pav2000/DevBoardSTM32F103CBT/CubeIDE/Examples/README.md

Постые примеры для платы, среда разработки CubeMX IDE <br>
<br>
1. TimerBlink.zip - мигание светодиодом от таймера <br>
2. USB_VCP.zip - создание виртуального COM порта на USB <br>
3. Пример Mass Storage Class (MSC) в качести хранилища используется spi flash w25q32.
При подключении платы к компу она определяется как флешка объемом 4 MB. Тестировалось на плате 1.5.
Лежит https://github.com/pav2000/USB_W25Q32<br>
4. Подключения китайского лидара (lidar MB-1R2T) к плате (v 1.4) https://github.com/pav2000/LidarStm32f103<br>
<br>
