pav2000/DevBoardSTM32F103CBT/Arduino/tools/README.md

Полезные утилиты/программы.<br>
<br>
ModbusTool.zip - программа эмуляции slave modbus на компе по windows. Предназначена для чтения/записи регистров modbus на master
 устройстве. Позволяет использовать различные функции и читать/писать несколько подряд регистров в цикле.
 В настройках можно выбрать параметры обмена и порядок байт (что важно) в данных. Недостаток - периодически хочет денег.<br>
 Программа является не уникальной и существет множесто аналогов ее под разные операционные системы.<br>
 <br>
 driver_ch340_341_arduino.zip - Виндовс драйвера для чипа ch340 (конвертор usb-uart). Обычно такие конверторы используются для
 соединения с компьютером устройств по rs485 интрефейсу (поверх которого может работать modbus протокол). <br>
<br>
