pav2000/DevBoardSTM32F103CBT/Board/Schematic_v150_2022-01-12.pdf

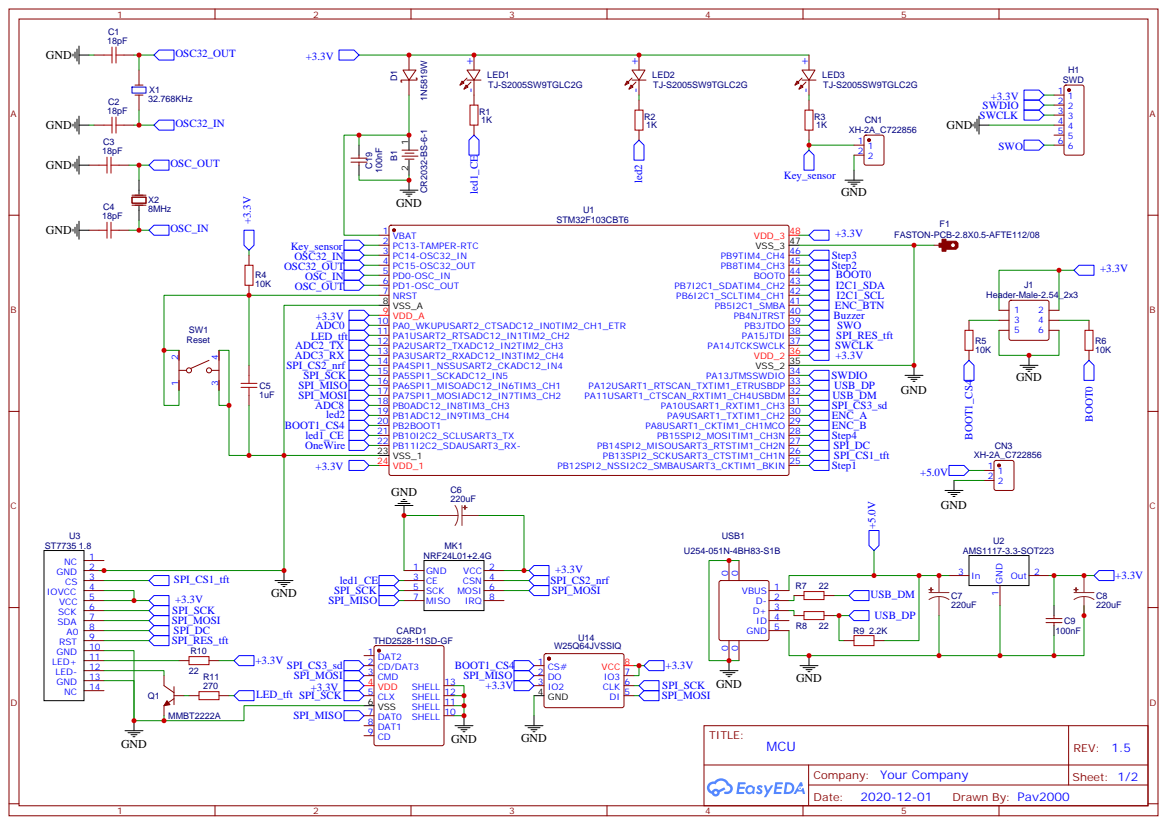
[picture p22: page 1]

SHELL 10 SHELL 11 SHELL 12 SHELL 13

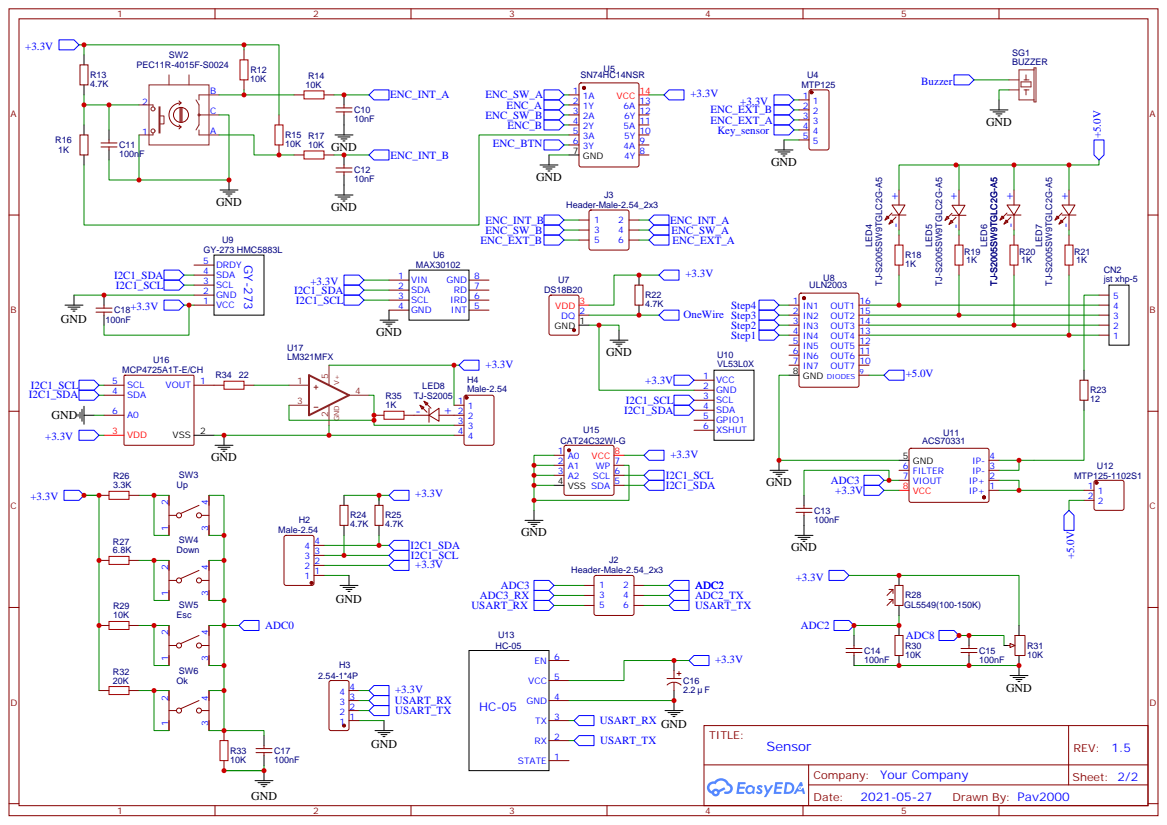
[picture p23: page 2]
