pav2000/DevBoardSTM32F103CBT/Board/Schematic_v140_2021-09-27.pdf

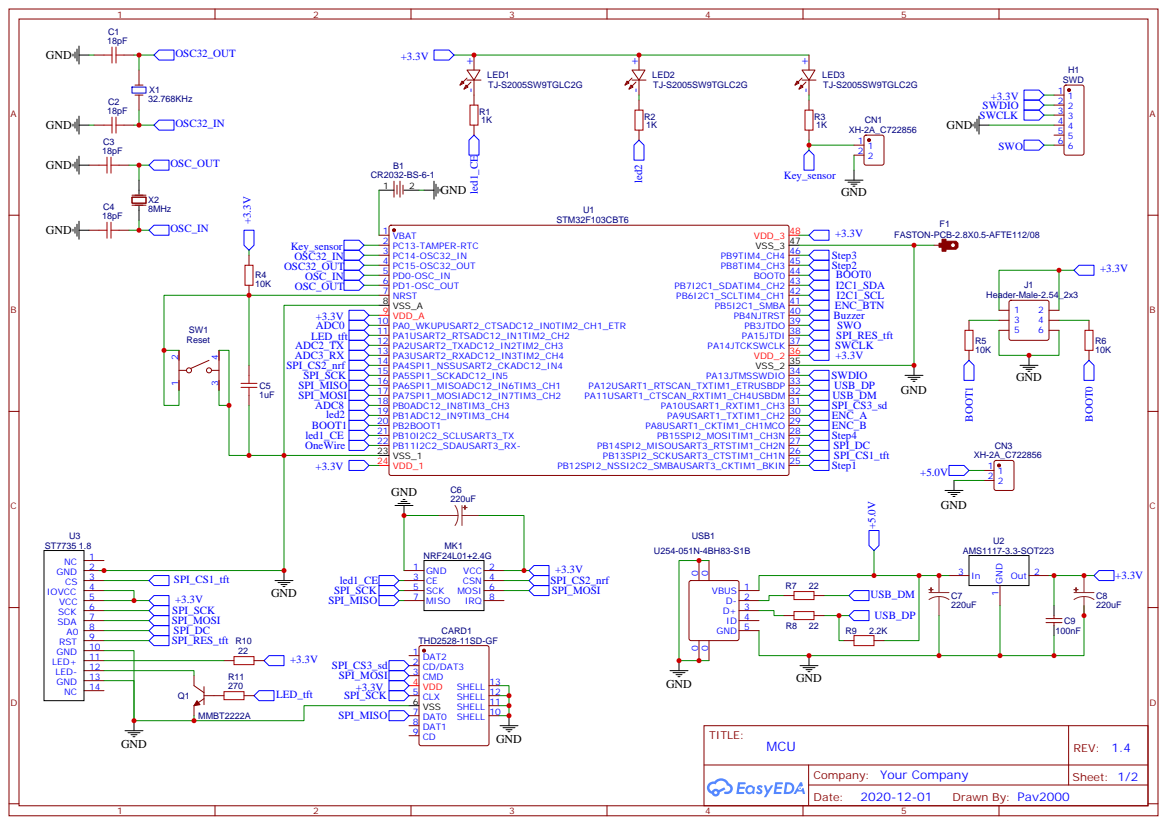
[picture p24: page 1]

SHELL 10 SHELL 11 SHELL 12 SHELL 13

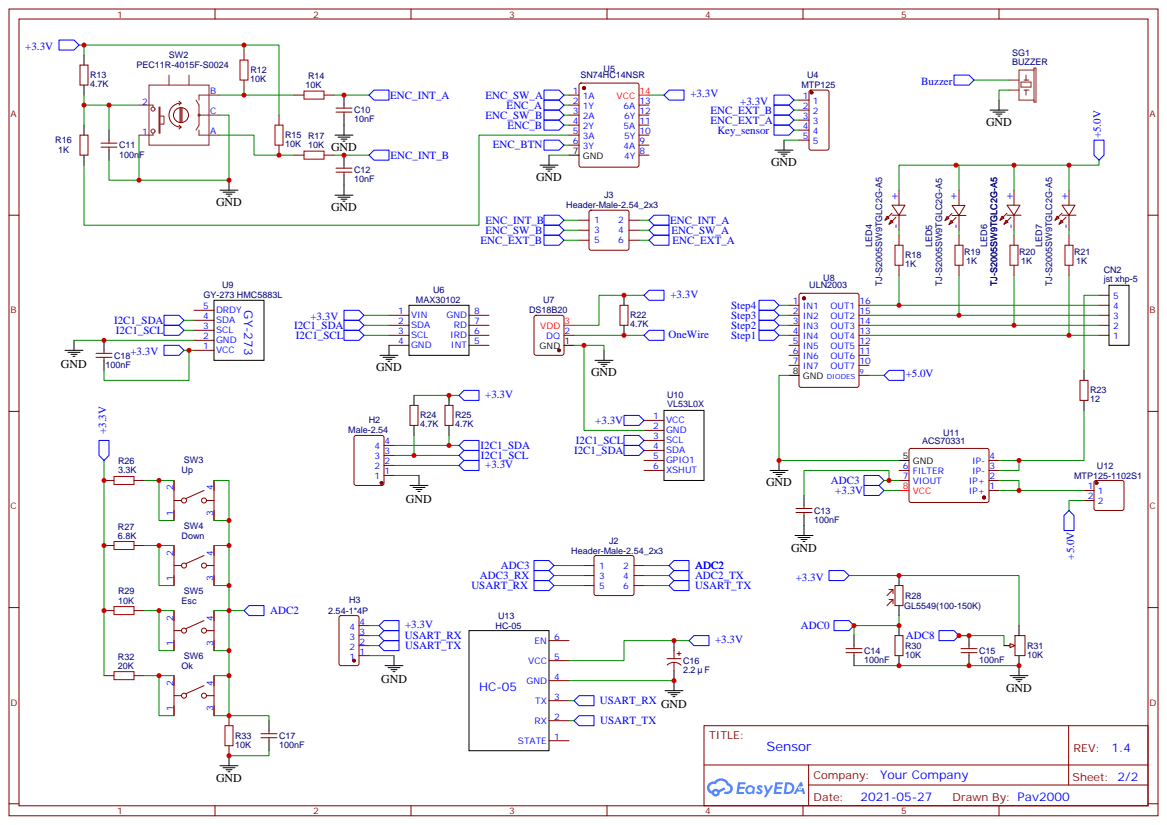
[picture p25: page 2]
