pav2000/DevBoardSTM32F103CBT/Board/Old_version/Schematic_v110_2021-06-04.pdf

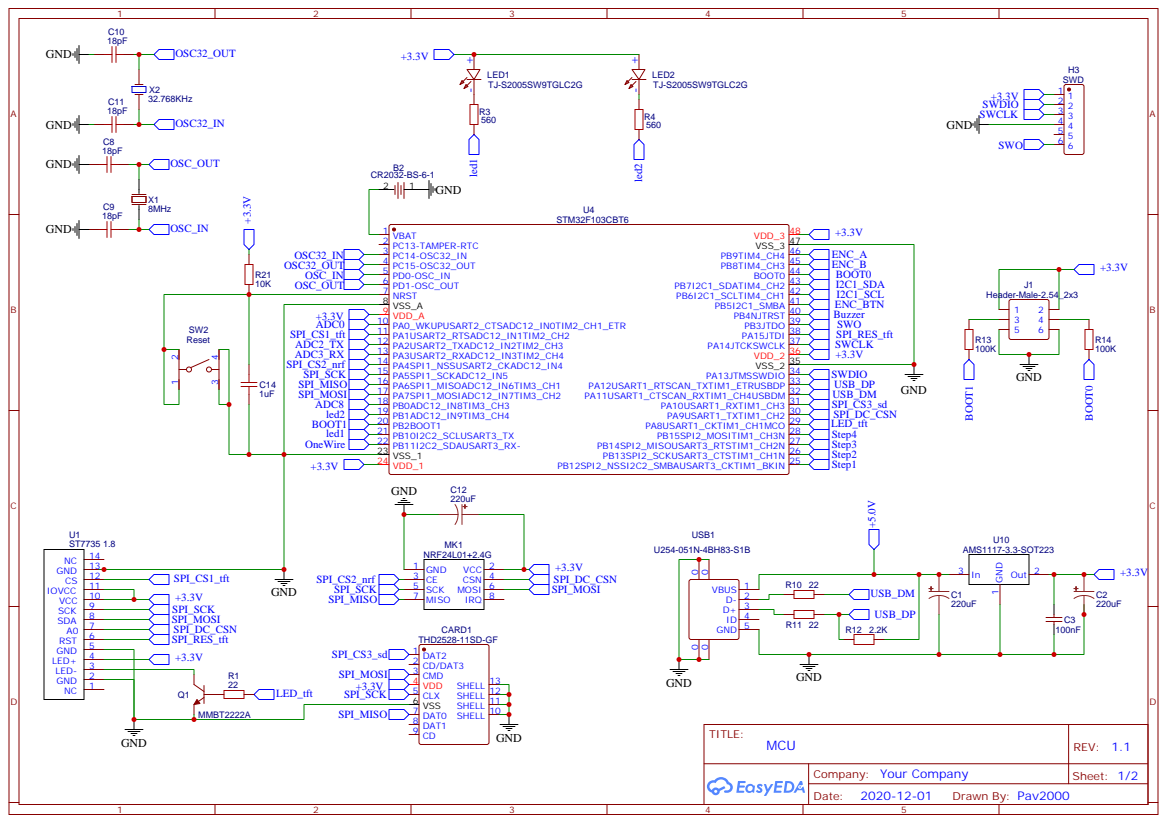
[picture p26: page 1]

SHELL 10 SHELL 11 SHELL 12 SHELL 13

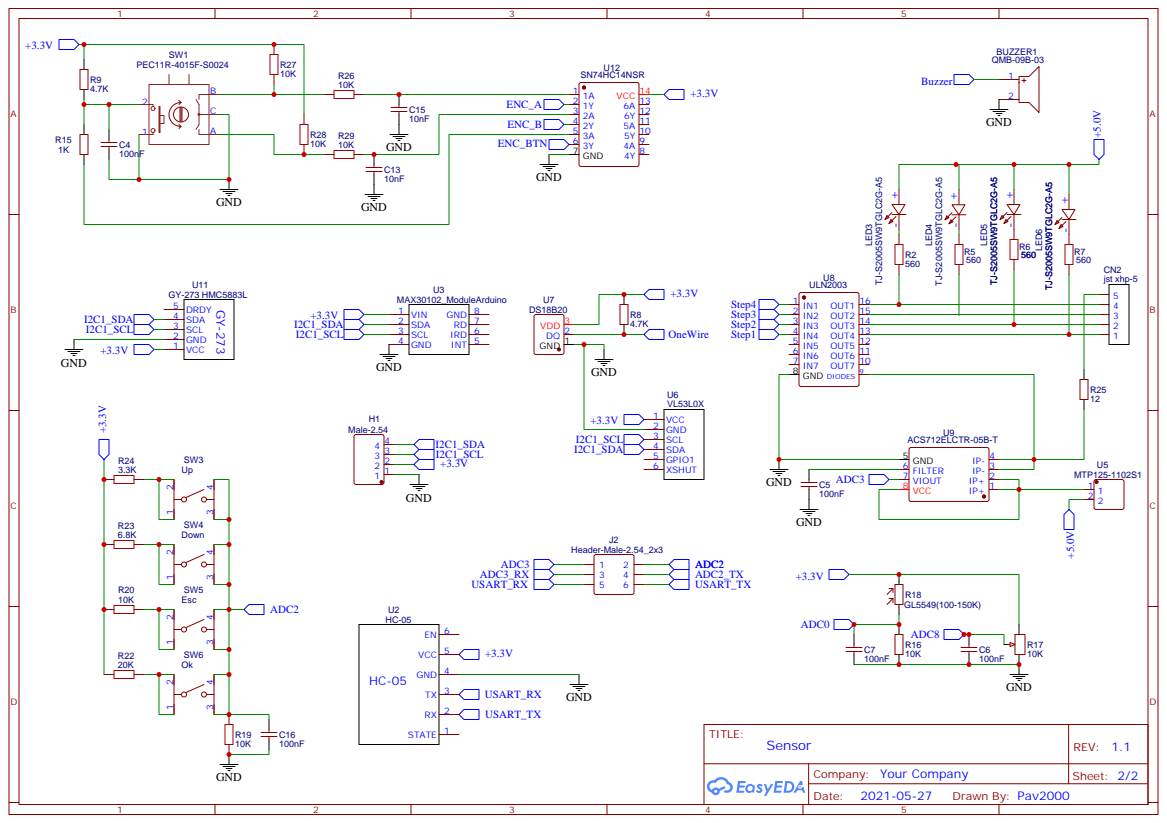
[picture p27: page 2]
