pav2000/DevBoardSTM32F103CBT/Board/Old_version/Schematic_v120_2021-07-21.pdf

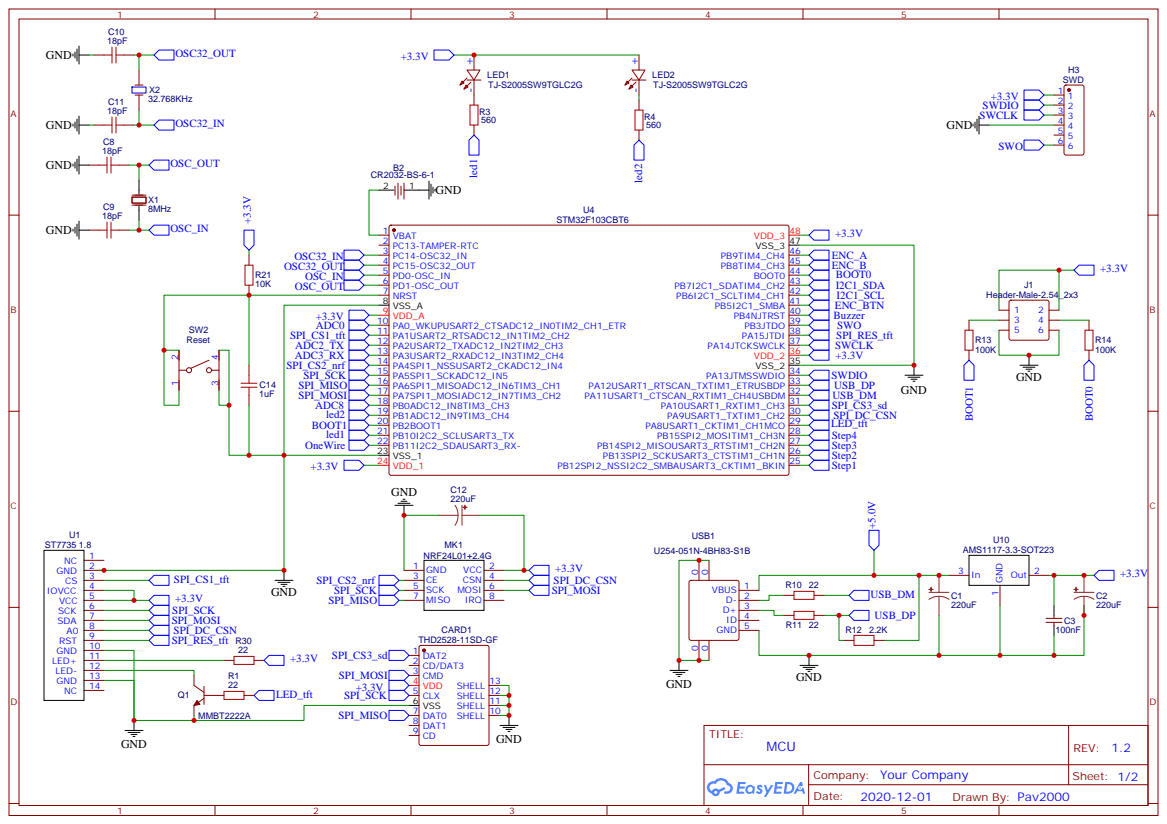
[picture p28: page 1]

SHELL 10 SHELL 11 SHELL 12 SHELL 13

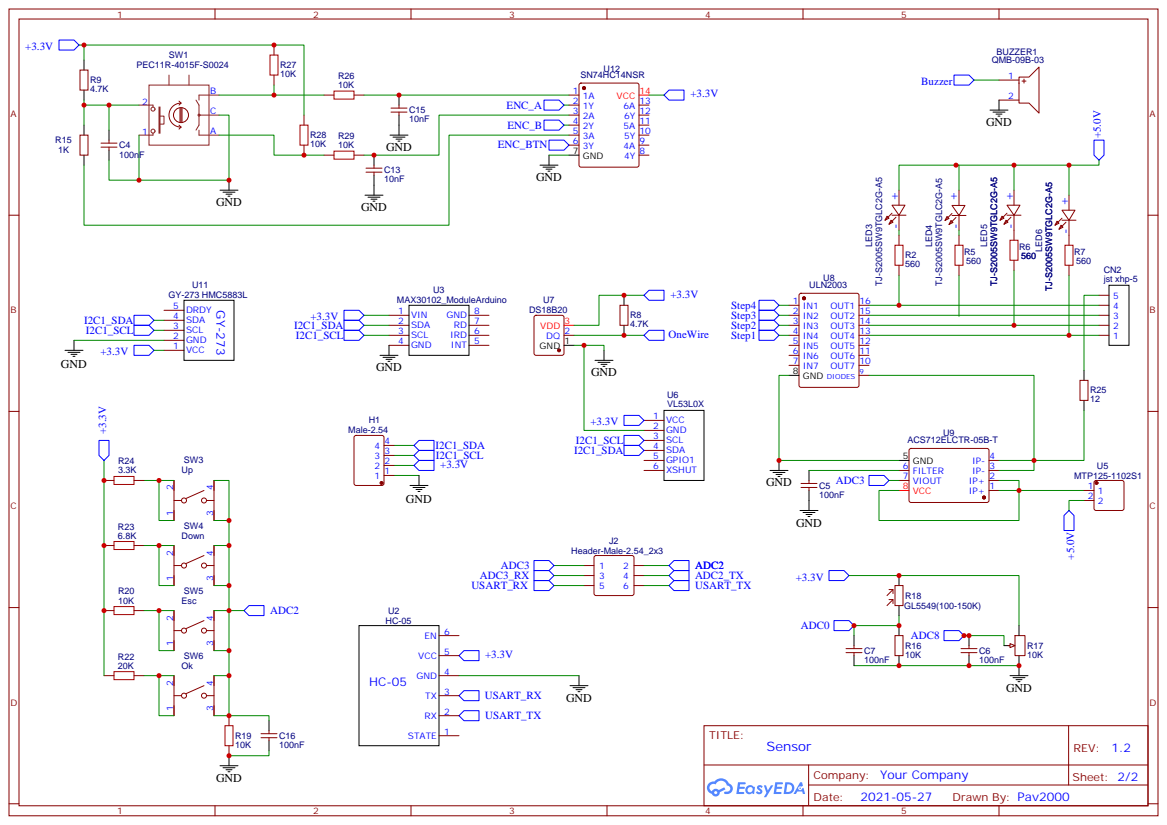
[picture p29: page 2]
