pav2000/DevBoardSTM32F103CBT/Board/Old_version/Schematic_v130_2021-08-02.pdf

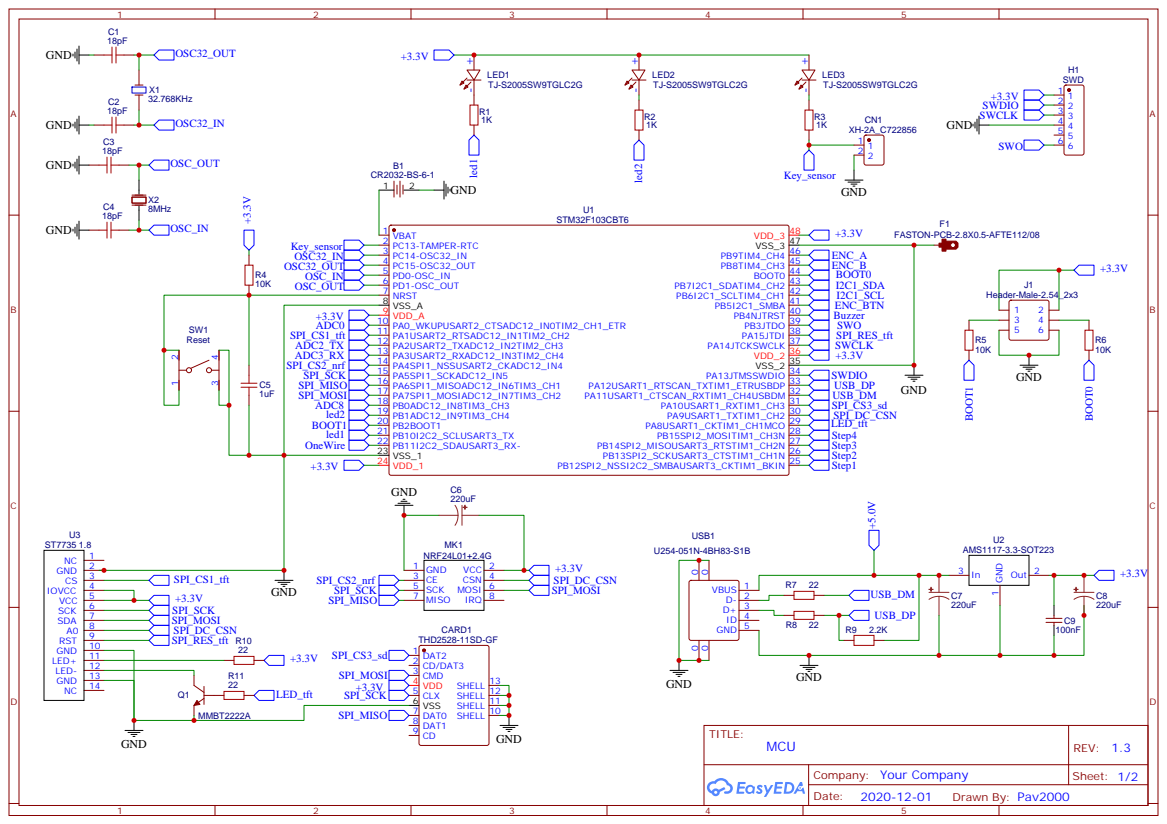
[picture p30: page 1]

SHELL 10 SHELL 11 SHELL 12 SHELL 13

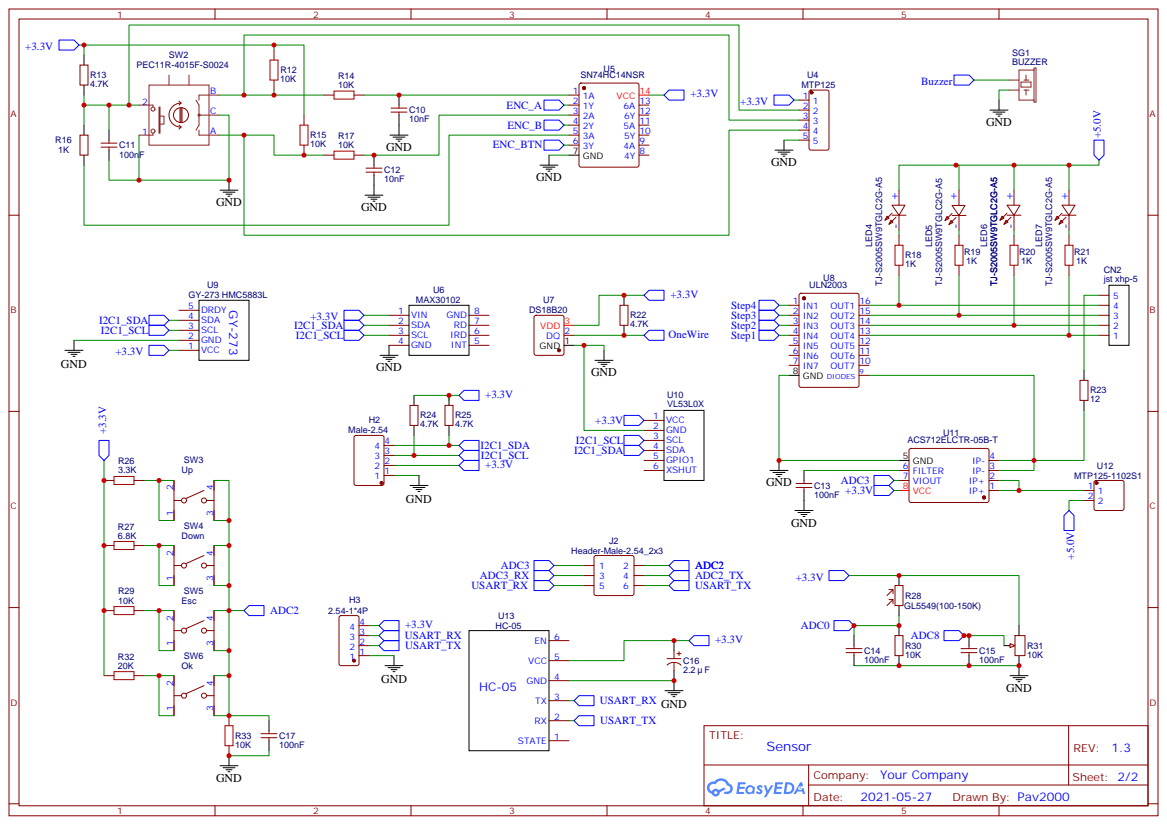
[picture p31: page 2]
