pav2000/DevBoardSTM32F103CBT/CubeIDE/LabMaketTest/Core/Src/main.c

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
/* Includes ------------------------------------------------------------------*/
#include "main.h"
#include "fatfs.h"

/* USER CODE BEGIN Includes */
#include "testimg.h"

/* USER CODE END Includes */

ADC_HandleTypeDef hadc1;

I2C_HandleTypeDef hi2c1;

RTC_HandleTypeDef hrtc;

SPI_HandleTypeDef hspi1;
DMA_HandleTypeDef hdma_spi1_tx;

TIM_HandleTypeDef htim1;
TIM_HandleTypeDef htim2;

/* USER CODE BEGIN PV */
RTC_TimeTypeDef RtcTime;
RTC_DateTypeDef RtcDate;

uint8_t r = 0;
char buf[64];
int EncVal=0;
const char *menu_main_text[NUM_MENU_MAIN]={"0.Test TFT st7735",
										   "1.Test analog sensor",
										   "2.Test key & leds",
										   "3.Test RTC stm32",
										   "4.Test ds18b20",
										   "5.Test I2C bus >>",
										   "6.Test motor&ACS70331",
										   "7.Test SD card",
										   "8.Test nrf24l01",
										   "9.Test SPI flash",
										   "a.Test fake stm chip"};

uint8_t menu_main = 0;
uint8_t menu_i2c = 0;
mMenu myMenu;   // текущее мению
/* USER CODE END PV */

void SystemClock_Config(void);
static void MX_GPIO_Init(void);
static void MX_DMA_Init(void);
static void MX_SPI1_Init(void);
static void MX_ADC1_Init(void);
static void MX_RTC_Init(void);
static void MX_TIM1_Init(void);
static void MX_TIM2_Init(void);
static void MX_I2C1_Init(void);
/* USER CODE BEGIN PFP */
extern void start_screen(void);
extern void beep(uint16_t t);
extern void beep_enc(void);
extern void menu_i2c_screen(void);
extern void test_TFT(void);
extern void test_ADC(void);
extern void test_keyADC_LEDS(void);
extern void test_RTC(void);
extern void test_ds18b20(void);
extern void scan_i2c(void);
extern void test_VL53L0x(void);
extern void test_max30102(void);
extern void test_hmc5883l(void);
extern void test_SD(void);
extern void test_nrf24(void);
extern void test_SPI_flash(void);
void test_Stepper(void);
/* USER CODE END PFP */

/* USER CODE BEGIN 0 */
uint32_t CalculateDayNumber(uint8_t Date, uint8_t Month, uint8_t Year)
{
	// Format:
	// DD.MM.YY
	uint32_t _Year = Year + 20;
	Month = (Month + 9) % 12;
	_Year = _Year - (Month / 10);
	return ((365 * _Year) + (_Year / 4) - (_Year / 100) + (_Year / 400) + (((Month * 306) + 5) / 10) + (Date - 1));
}

void CalculateDateFromDayNumber(uint32_t DayNumber, uint8_t *Date, uint8_t *Month, uint8_t *Year)
{
	uint32_t _Date, _Month, _Year;
	_Year = ((10000 * DayNumber) + 14780) / 3652425;
	int32_t ddd = DayNumber - ((365 * _Year) + (_Year / 4) - (_Year / 100) + (_Year / 400));
	if (ddd < 0)
	{
		_Year -= 1;
		ddd = DayNumber - ((365 * _Year) + (_Year / 4) - (_Year / 100) + (_Year / 400));
	}
	int32_t mi = ((100 * ddd) + 52) / 3060;
	_Month = (mi + 2) % 12 + 1;
	_Year = _Year + (mi + 2)/12;
	_Date = ddd - ((mi * 306) + 5)/10 + 1;
	*Date = _Date;
	*Month = _Month;
	*Year = _Year - 20;
}
/* USER CODE END 0 */

/**
  * @brief  The application entry point.
  * @retval int
  */
int main(void)
{
  /* USER CODE BEGIN 1 */
uint8_t old_menu = menu_main;  // Старая позиция меню
  /* USER CODE END 1 */

  /* MCU Configuration--------------------------------------------------------*/

  /* Reset of all peripherals, Initializes the Flash interface and the Systick. */
  HAL_Init();

  /* Configure the system clock */
  SystemClock_Config();

  /* Initialize all configured peripherals */
  MX_GPIO_Init();
  MX_DMA_Init();
  MX_SPI1_Init();
  MX_ADC1_Init();
  MX_RTC_Init();
  MX_FATFS_Init();
  MX_TIM1_Init();
  MX_TIM2_Init();
  MX_I2C1_Init();
  /* USER CODE BEGIN 2 */

  ST7735_Init();          // Не забываем в кубе настроить DMA
 // ST7735_Backlight_On(); // Включить подсветку дисплея
  ST7735_SetRotation(3);
  ST7735_FillScreen(ST7735_WHITE);
  ST7735_DrawImage(0, 10, 160, 58, (const uint16_t*) stm32logo); // вывести заставку
  ST7735_DrawString(0, 108, "Hardware version:", Font_7x10, ST7735_RED, ST7735_WHITE);
  ST7735_DrawString(130, 108, HARDWARE, Font_7x10, ST7735_RED, ST7735_WHITE);

  ST7735_DrawString(0, 118, "Test prog version:", Font_7x10, ST7735_RED, ST7735_WHITE);
  ST7735_DrawString(130, 118, VERSION, Font_7x10, ST7735_RED, ST7735_WHITE);
  beep(200);
  HAL_TIM_PWM_Start(&htim2, TIM_CHANNEL_2); // Включить ШИМ на подсветку дисплея
  for (uint8_t i=0;i<100;i++){
	  ST7735_Backlight(i);                  // Установить ярокость
	  HAL_Delay(20);
  }
// test_VL53L0x();
// test_at24c128();
  HAL_ADCEx_Calibration_Start(&hadc1);  // Калибровка ацп
  /* USER CODE END 2 */

  /* Infinite loop */
  /* USER CODE BEGIN WHILE */
 // HAL_GPIO_WritePin(GPIOB, LED2_Pin, GPIO_PIN_SET);    // Установить светодиод 2 в 1
  HAL_GPIO_WritePin(LED1_CE_NRF_GPIO_Port, LED1_CE_NRF_Pin, GPIO_PIN_RESET);    // Установить светодиод 1 в 0
 // HAL_GPIO_WritePin(GPIOA, TFT_LED_Pin, GPIO_PIN_SET); // Включить подсветку дисплея


  start_screen();
  TIM1->ARR = (NUM_MENU_MAIN-1)*2+1; // Установить максимальное значение энкодера в ДВА раза больше чем пунктов меню (срабатываение на один щелчек энкодера)
  TIM1->CNT = 0; // нулевой пункт меню
  HAL_TIM_Encoder_Start(&htim1, TIM_CHANNEL_ALL); // Включить энкодер

  HAL_NVIC_EnableIRQ(EXTI9_5_IRQn);
 // myMenu=mMain;    // текущее меню - главное
  while (1)
  {
	  HAL_GPIO_TogglePin(LED1_CE_NRF_GPIO_Port, LED1_CE_NRF_Pin); // Инвертирование состояния выхода.
	  HAL_Delay(50);                       // Пауза 50 миллисекунд.

	 menu_main = __HAL_TIM_GET_COUNTER(&htim1)/2;  // Прочитать значение энкодера

     if(old_menu!=menu_main) // Надо перерисовать пункт меню
     {
 //	  itoa(menu_main+1,buf,16);
 //	  ST7735_DrawString(150, 1, buf, Font_7x10, ST7735_RED, ST7735_BLUE); // текущий атом меню
    	// Старое меню восстанавливаем
   	  ST7735_FillRectangle(0, 2+(old_menu+1)*STR_H, 160-1,STR_H, ST7735_BLACK);
      ST7735_DrawString(0, 2+(old_menu+1)*STR_H,menu_main_text[old_menu], Font_7x10, ST7735_WHITE, ST7735_BLACK);
    	// Новое рисуем
   	  ST7735_FillRectangle(0, 2+(menu_main+1)*STR_H, 160-1,STR_H, ST7735_WHITE);
      ST7735_DrawString(0, 2+(menu_main+1)*STR_H,menu_main_text[menu_main], Font_7x10, ST7735_BLUE, ST7735_WHITE);
      old_menu=menu_main;
      beep_enc();
     }
     // Нажата кнопка
     if (HAL_GPIO_ReadPin(GPIOB, ENC_BTN_Pin) == 1) {
    	 beep_enc();
    	 switch (menu_main){
    		case 0: test_TFT();start_screen(); break;
    		case 1: test_ADC();start_screen(); break;
    		case 2: test_keyADC_LEDS();start_screen(); break;
      		case 3: test_RTC();start_screen(); break;
      		case 4: test_ds18b20();start_screen(); break;
      		case 5: menu_i2c_screen();TIM1->CNT=5*2; start_screen(); break; // Подменю, с возвратом на ту же позицию
      		case 6: test_Stepper();start_screen(); break;
    		case 7: test_SD();start_screen(); break;
    		case 8: test_nrf24();start_screen(); break;
    		case 9: test_SPI_flash();start_screen(); break;
    		case 10: test_fake_stm32();start_screen(); break;
      		default: break;

    	}
     }

    /* USER CODE END WHILE */

    /* USER CODE BEGIN 3 */
  }
  /* USER CODE END 3 */
}

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
/* USER CODE BEGIN 4 */
/*
// Прерывание от энкодера
static uint32_t tick_encoder=0;
#define ENC_BOUNCE   10  // Дребезг энкодера
void HAL_GPIO_EXTI_Callback(uint16_t GPIO_Pin)
{

  if(GPIO_Pin == ENC_B_Pin) {  // Нужное прерываение от нужной ножки
      HAL_GPIO_TogglePin(GPIOB, LED2_Pin); // Инвертирование состояния выхода.
      if((HAL_GetTick()-tick_encoder>ENC_BOUNCE)&&(HAL_GPIO_ReadPin(GPIOB, ENC_B_Pin) == 0)) {// С прошедшего прерываения прошло более 20 мс - это не дребезг
      tick_encoder=HAL_GetTick();
        switch (myMenu){
   		case mMain:// {
   		    if ((HAL_GPIO_ReadPin(GPIOB, ENC_A_Pin) == 1)&&(HAL_GPIO_ReadPin(GPIOB, ENC_A_Pin) == 1)) { // Кто-то крутит ручку по часовой стрелке
   		    	HAL_Delay(1);   if (HAL_GPIO_ReadPin(GPIOB, ENC_A_Pin) == 1)
   		              if(menu_main <  NUM_MENU_MAIN-1) menu_main++; }
   		      else if ((HAL_GPIO_ReadPin(GPIOB, ENC_A_Pin) == 0)&&(HAL_GPIO_ReadPin(GPIOB, ENC_A_Pin) == 0)) { // Ручку крутят против часовой стрелки
   		    	HAL_Delay(1);   if (HAL_GPIO_ReadPin(GPIOB, ENC_A_Pin) == 0)
   		                  if(menu_main > 0) menu_main--; }

   			break;

   		case mI2C: // {
   		    if ((HAL_GPIO_ReadPin(GPIOB, ENC_A_Pin) == 1)&&(HAL_GPIO_ReadPin(GPIOB, ENC_A_Pin) == 1)) { // Кто-то крутит ручку по часовой стрелке
 		    	HAL_Delay(1);   if (HAL_GPIO_ReadPin(GPIOB, ENC_A_Pin) == 1)
     		    	if(menu_i2c <  NUM_MENU_I2C-1) menu_i2c++; }
   		      else if ((HAL_GPIO_ReadPin(GPIOB, ENC_A_Pin) == 0)&&(HAL_GPIO_ReadPin(GPIOB, ENC_A_Pin) == 0)) { // Ручку крутят против часовой стрелки
   		    	HAL_Delay(1);   if (HAL_GPIO_ReadPin(GPIOB, ENC_A_Pin) == 1)
       	    	  if(menu_i2c > 0) menu_i2c--; }
     		break;

      }

  } else{
   __NOP();
  } }
  __HAL_PWR_CLEAR_FLAG(PWR_FLAG_WU);
}
*/
/* USER CODE END 4 */
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
