pav2000/DevBoardSTM32F103CBT/CubeIDE/LabMaketTest/Core/Inc/main.h

#define HARDWARE "1.50"     // Версия платы (обязательно указывать)
#define VERSION  "1.58"     // Версия тестовой программы
#define STR_H           10  // Высота строки
#define NUM_MENU_MAIN   11  // Число пунктов основного меню
#define NUM_MENU_I2C    7   // Число пунктов i2c меню
#define LED3_Pin GPIO_PIN_13
#define LED3_GPIO_Port GPIOC
#define SPI_CS2_nrf_Pin GPIO_PIN_4
#define SPI_CS2_nrf_GPIO_Port GPIOA
#define LED2_Pin GPIO_PIN_1
#define LED2_GPIO_Port GPIOB
#define BOOT1_CS4_Pin GPIO_PIN_2
#define BOOT1_CS4_GPIO_Port GPIOB
#define LED1_CE_NRF_Pin GPIO_PIN_10
#define LED1_CE_NRF_GPIO_Port GPIOB
#define ONEWIRE_Pin GPIO_PIN_11
#define ONEWIRE_GPIO_Port GPIOB
#define STEP1_Pin GPIO_PIN_12
#define STEP1_GPIO_Port GPIOB
#define TFT_CS_Pin GPIO_PIN_13
#define TFT_CS_GPIO_Port GPIOB
#define TFT_DC_Pin GPIO_PIN_14
#define TFT_DC_GPIO_Port GPIOB
#define STEP4_Pin GPIO_PIN_15
#define STEP4_GPIO_Port GPIOB
#define ENC_B_Pin GPIO_PIN_8
#define ENC_B_GPIO_Port GPIOA
#define ENC_A_Pin GPIO_PIN_9
#define ENC_A_GPIO_Port GPIOA
#define SD_CS_Pin GPIO_PIN_10
#define SD_CS_GPIO_Port GPIOA
#define TFT_RST_Pin GPIO_PIN_15
#define TFT_RST_GPIO_Port GPIOA
#define INT_MAX30102_Pin GPIO_PIN_3
#define INT_MAX30102_GPIO_Port GPIOB
#define BUZZER_Pin GPIO_PIN_4
#define BUZZER_GPIO_Port GPIOB
#define ENC_BTN_Pin GPIO_PIN_5
#define ENC_BTN_GPIO_Port GPIOB
#define STEP2_Pin GPIO_PIN_8
#define STEP2_GPIO_Port GPIOB
#define STEP3_Pin GPIO_PIN_9
#define STEP3_GPIO_Port GPIOB
