pav2000/DevBoardSTM32F103CBT/CubeIDE/LabMaketTest/Core/Inc/testimg.h

/*
 * testimg.h
 *
 *  Created on: Sep 15, 2020
 *      Author: Admin
 */

#ifndef INC_TESTIMG_H_
#define INC_TESTIMG_H_
const uint16_t test_img_128x128[][128] = {
{0x0B6B,0x0B63,0x0B6B,0x2B6B,0x2B6B,0x2B6B,0x2C6B,0x2C6B,0x2B6B,0x2C6B,0xAC73,0xAB84,0xCB9D,0xECB6,0xCCCF,0xECE7,0xECEF,0xEBF7,0xEAFF,0xEBFF,0xEBFF,0xEBFF,0xEDF7,0xEDE7,0xCCDF,0xAADF,0x4FCF,0xDDB6,0xDFB6,0xDFBE,0x1E96,0xFC74,0xFC53,0xDD5B,0xBE7C,0x5F95,0xBFA5,0xFFAD,0x1F8D,0xFC63,0x7753,0xD44A,0xD552,0x355B,0xF352,0x7142,0xB652,0x3B5B,0x3D7C,0x7D6C,0x5E8D,0x7EBE,0xDFCE,0x9B95,0x5A74,0x5A8C,0xBC94,0xBB8C,0xB88C,0xB78C,0x5484,0x137C,0x347C,0x5384,0x7473,0x9B73,0xDFAD,0xDFBE,0x1FA6,0xB974,0x303A,0x5129,0xB639,0x1E7C,0x3FB6,0xFFBE,0x3D7D,0x3D64,0x1E6C,0xBD5B,0x5C4B,0x7C53,0x3C4B,0xFD42,0x3D53,0x7FA5,0x9FB6,0x3F8D,0x7F74,0x9F74,0x5E74,0xDF84,0x5FB6,0x5A8D,0x795B,0xBE63,0x9F7C,0x3FB6,0xDFCE,0x7FB6,0x7E95,0xBFCE,0xFDB6,0xCE63,0xA95A,0xC95A,0x895A,0x8A5A,0x695A,0x6952,0x6952,0x4952,0x484A,0x484A,0x084A,0x084A,0x0742,0xE741,0xC741,0xC739,0xC639,0xA639,0x8631,0x8531,0x6531,0x6531,0x4429,0x2429,},
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
		0XFF,0XFF,0XFF,0XFF,0XFF,0XFF,0XFF,0XFF,0XFF,0XFF,0XFF,0XFF,0XFF,0XFF,0XFF,0XFF,
		0XFF,0XFF,0XE7,0XFF,0X45,0X7B,0X0C,0XDB,0X04,0XFB,0X04,0XFC,0X04,0XFC,0X0C,0XDA,
		0X2C,0XB7,0XC7,0XFF,0XF7,0XFF,0XFF,0XFF,0XFF,0XFF,0XF7,0XFF,0XC7,0XFF,0X34,0XD8,
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
