pav2000/DevBoardSTM32F103CBT/(commit log)

2021-10-25 Первоначальная загрузка
    [LabMaketTest Debug.cfg]
2021-11-10 Подготовка к переходу на плату версии 1.4
2021-11-10 up timer encoder
    [LabMaketTest Debug.cfg]
2021-11-11 Переход на железо 1.4 экран заработал, использование таймера для работы с энкодером version 1.31
2021-11-11 PWM control backlight TFT ver. 1.32
2021-11-11 up 1.34 полная реализация по железу 1.4
2021-11-12 ver 1.35, обновление readme, добавлены схемы предыдущих версий плат.
2021-12-09 Добавлено описание различий версий платы и оисания отдельных микросхем
2022-01-10 Add arduino Modbus RTU example & lib
2022-01-10 Обновление ветки для Arduino
2022-01-10 Добавлено описание графической библиотеки Adafruit_GFX
2022-01-12 Начало перехода на железо версии 1.5.
    Добавление коментариев для новой версии платы.
2022-01-12 Версия 1.36
    Добавлено для платы версии 1.50 тестирование SPI флаш памяти. На плате
    установлено w25q32, При тесте происходит чтение служемной информации о
    чипе.
2022-01-12 Версия 1.37
    Алаптация аналоговых входов по железо версии 1.50. Было поменяно местами
    два аналоговых входа adc0 и adc2.
2022-01-12 Версия 1.38
2022-01-13 версия 1.39
    Добавлен простейший тест скороси чтения/записи spi flash памяти
2022-01-17 Версия 1.40
    Добавлен тест чипа at24c128 с использованием HAL
2022-01-17 Версия 1.41
    Добавлен тест dac mcp4725 (i2c)
2022-01-18 update
    Добавленлена программа обмена по modbus и драйвера для чипа ch340
2022-01-20 Update
    Добавление примера для cubeide
2022-01-20 Пример USB_W25Q32 перенесен в отдельный репозитарий.
2022-06-21 ver 1.44 1.Добавлен тест на определение оригинальности stm32f103 (определение подделок) 2. Временно часы тактируются от внутреннего генератора 4-кГц.
    [LabMaketTest Debug.cfg]
2023-01-10 Добавление даташита на датчик AS5600
2023-01-10 lib as5600
    Добавлены библиотеки для работы с датчиком в среде arduino, добавлен список ссылок.
2023-01-10 Add step motor
    Добавлена документация и либы на управление шаговым двигателем
2023-01-11 update redme
    Перевел описание платы на английский язык
2023-01-24 Add samples as5600
    Добавлен протестированный пример на макете (stm32f103) работы с датчиком as5600 по шине i2c.
2023-03-09 update as5600 info
    Добавлена информация по датчику as5600
2023-03-09 Update hmc5883l info
    Добавлена информация о калибровке датчика hmc5883l
2023-03-29 Update modbus_TEST
    Обновление примера для ардуино modbus_TEST
2023-04-19 Update VL53L0X
    Улучшена работа с датчиком VL53L0X. Добавлена аналоговая шкала на этот датчик. Работа по шине i2c переведена на HAL.
2023-04-21 Update
    Исправлена ошибка при работе с флешь памятью at24cxx
    [LabMaketTest.ioc, main.c, main.h, test.c, user_at24cxx.c, user_at24cxx.h]
2023-04-23 Update 1.57
    Частично пофиксил проблему повторного запуска VL53L0X.
2023-04-23 Update
    Немного переделал шкалу VL53L0X
2023-12-23 Добавил информацию по микропереключателю msw-12
2024-01-10 Добавлена информация о датчике HС-SR04
2024-01-10 Test HС-SR04 & KEY1
    Добавлена программа для тестирования датчика HС-SR04 и кнопки KEY1
    Описана проблема с 8 версией java
2024-04-16 Добавление дополнительных библиотек для ультразвукового датчика
2025-02-18 Добавлены библиотеки и примеры использования GPS NEO6 и PWM на чипеPCA9685
2025-02-18 Добавлены даташиты для GPS и PCA9685
2025-02-18 Обновление сканера I2C
2025-02-19 Добавлена библиотека для парсера протокола NMEA
2025-03-13 Добавлен даташит на дисплей ST7735
